Mahyacheraghii/Thermostat/firmware/include/User_Setup.h

#define ILI9341_DRIVER
#define TFT_MOSI 23
#define TFT_MISO 19
#define TFT_SCLK 18
#define TFT_CS 15
#define TFT_DC 2
#define TFT_RST 4
#define TOUCH_CS 5
#define TOUCH_IRQ 33

#define SPI_FREQUENCY 40000000 // ۴۰ مگاهرتز (حداکثر استاندارد)
#define SPI_READ_FREQUENCY 20000000
#define SPI_TOUCH_FREQUENCY 2000000 // این رو بالا نبرید! چیپ تاچ کنده.
