Mahyacheraghii/Thermostat/firmware/src/GUI_Variables.c

#include "GUI.h"



lv_obj_t* GUI_Screen__screen;
lv_obj_t* GUI_Screen__wifi;
lv_obj_t*  GUI_Image__screen__dashboardImg;
lv_obj_t*  GUI_Image__screen__wifiImage;
lv_obj_t*  GUI_Arc__screen__arc;
lv_obj_t*  GUI_Container__screen__DataContainer;
lv_obj_t*   GUI_Container__screen__moistureContainer;
lv_obj_t*    GUI_Image__screen__moistureImg;
lv_obj_t*    GUI_Label__screen__moisture;
lv_obj_t*   GUI_Label__screen__currentTemperature;
lv_obj_t*   GUI_Label__screen__setTemperature;
lv_obj_t*   GUI_Label__screen__set_to;
lv_obj_t*  GUI_Container__screen__controlleersContainer;
lv_obj_t*   GUI_Image__screen__moodImg;
lv_obj_t*   GUI_Image__screen__fanImg;
lv_obj_t*   GUI_Image__screen__pumpImg;
lv_obj_t*   GUI_Image__screen__powerImg;
lv_obj_t*  GUI_Button__wifi__backBtn;
lv_obj_t*   GUI_Label__wifi__backLabel;
lv_obj_t*  GUI_Label__wifi__title;
lv_obj_t*  GUI_TextArea__wifi__ssid;
lv_obj_t*  GUI_TextArea__wifi__pass;
lv_obj_t*  GUI_Button__wifi__connectBtn;
lv_obj_t*   GUI_Label__wifi__connectLabel;
lv_obj_t*  GUI_Button__wifi__clearBtn;
lv_obj_t*   GUI_Label__wifi__clearLabel;
lv_obj_t*  GUI_Label__wifi__status;
lv_obj_t*  GUI_Keyboard__wifi__keyboard;


lv_style_t GUI_Style__class_720QKVxWEmbvhM__;
lv_style_t GUI_Style__class_wKRNl64hJph3yK__;
lv_style_t GUI_Style__class_BRPSMN5kLlcn7C__;
lv_style_t GUI_Style__class_THgObigAvqHpFq__;
lv_style_t GUI_Style__class_kdhj6JKmHjoRTB__;
lv_style_t GUI_Style__class_JqUcMs1ZNPRfQq__;
lv_style_t GUI_Style__class_MsKIDbZdEXuzIO__;
lv_style_t GUI_Style__class_0TWSkus0ZPqgtj__;
lv_style_t GUI_Style__class_VRI9xFdITfSk2x__;
lv_style_t GUI_Style__class_1nSloISkFO20jp__;
lv_style_t GUI_Style__class_Mjy6X8hngx7TUa__;
