Mahyacheraghii/Thermostat/(commit log)

2026-01-03 fix: updated sensors.cpp to match SHT3x
    [sensors.cpp]
2026-01-03 fix: updated hysteresis value to 1.0f
    [state_machine.cpp]
2026-01-03 fix: fixed wifi and mqtt settings
    [mqtt.cpp, mqtt.h, wifi_secure_shim.h]
2026-01-03 fix: build filter
2026-01-03 fix: include real images
    [GUI.h, ui.cpp]
2026-01-03 fix: ui, touch and assests
    [GUI.h, User_Setup.h, touch.cpp]
2026-01-03 fix: minor ui fixes
    [ui.cpp]
2026-01-04 fix: fixed ui for better set temp and current temp undrestanding
    [ui.cpp]
2026-01-04 fix: added touchscreen pins and a bit of debugging
    [touch.cpp]
2026-01-05 fix: new ui, slow screen
    [GUI.h, User_Setup.h, mqtt.cpp]
2026-01-05 fix: better touch speed and default wifi user-pass
    [User_Setup.h, main.cpp, sensors.cpp, touch.cpp, ui.cpp, ui_callbacks.cpp]
2026-01-05 fix: default wifi user pass
    [mqtt.h]
2026-01-05 fix: wifi screen ui improvement and power icon touch fix
    [User_Setup.h, main.cpp, mqtt.cpp, mqtt.h, ui_callbacks.cpp]
2026-01-05 fix: trying to solve NVS error
    [main.cpp]
2026-01-06 fix: avoid conflicts between fans when deltaC is 8 degrees
    [state_machine.cpp]
2026-01-06 fix: fixed mqtt and wifi connection
    [mqtt.cpp, mqtt.h]
